Jingyi-11/Power-Grid-Frequency-Monitoring-System/docs/project Gannt Chart.pdf

Untitled Gantt Project | 16 Oct 2024
Gantt Chart | 4
Name | Begin date | End date | Priority | functional
Research & Requirements Analysis | 26/09/2024 | 11/10/2024 NORMAL
choose project direction | 26/09/2024 | 03/10/2024 NORMAL
Make Project plan | 07/10/2024 | 08/10/2024 NORMAL
write functional specification | 04/10/2024 | 11/10/2024 NORMAL
Hardware Development | 14/10/2024 | 29/11/2024 NORMAL
voltage measuring circuit design and testing | 14/10/2024 | 01/11/2024 NORMAL
purchase availble devices | 04/11/2024 | 04/11/2024 NORMAL
Project Review meeting 1 | 01/11/2024 | 01/11/2024 NORMAL
physical circuit implement | 05/11/2024 | 19/11/2024 NORMAL
microcontroller connection and data visualise | 18/11/2024 | 29/11/2024 NORMAL
Project Review meeting 2 | 29/11/2024 | 29/11/2024 NORMAL
write draft introduction and project methodology | 29/11/2024 | 06/12/2024 NORMAL
Submit Draft Introduction | 09/12/2024 | 09/12/2024 NORMAL
Academic Malpractice Awareness training (BB) | 13/12/2024 | 13/12/2024 NORMAL
Software Development | 27/01/2025 | 03/03/2025 NORMAL
coding for instant frequency visualization | 27/01/2025 | 03/02/2025 NORMAL
coding for data collection and store | 03/02/2025 | 21/02/2025 NORMAL
wireless communication implement | 24/02/2025 | 03/03/2025 NORMAL
write draft of final report | 24/02/2025 | 07/03/2025 NORMAL
Submit Draft of Final Report | 07/03/2025 | 07/03/2025 NORMAL
Optimization & Finalization | 10/03/2025 | 04/04/2025 NORMAL
check hardware and software | 10/03/2025 | 17/03/2025 NORMAL
modify the final report | 17/03/2025 | 04/04/2025 NORMAL
Submit Final Report | 04/04/2025 | 04/04/2025 NORMAL
Final Demonstration | 28/04/2025 | 28/04/2025 NORMAL
2024 | 2025
September | October | November | December | January | February | March | April | May
Hardware Development Project Review meeting 1 purchase availble devices Project Review meeting 2 Submit Draft Introduction Academic Malpractice Awareness train... | Submit Draft of Final Report Submit Final Report | Final Demonstration
