Jingyi-11/Power-Grid-Frequency-Monitoring-System/docs/schematic.PNG

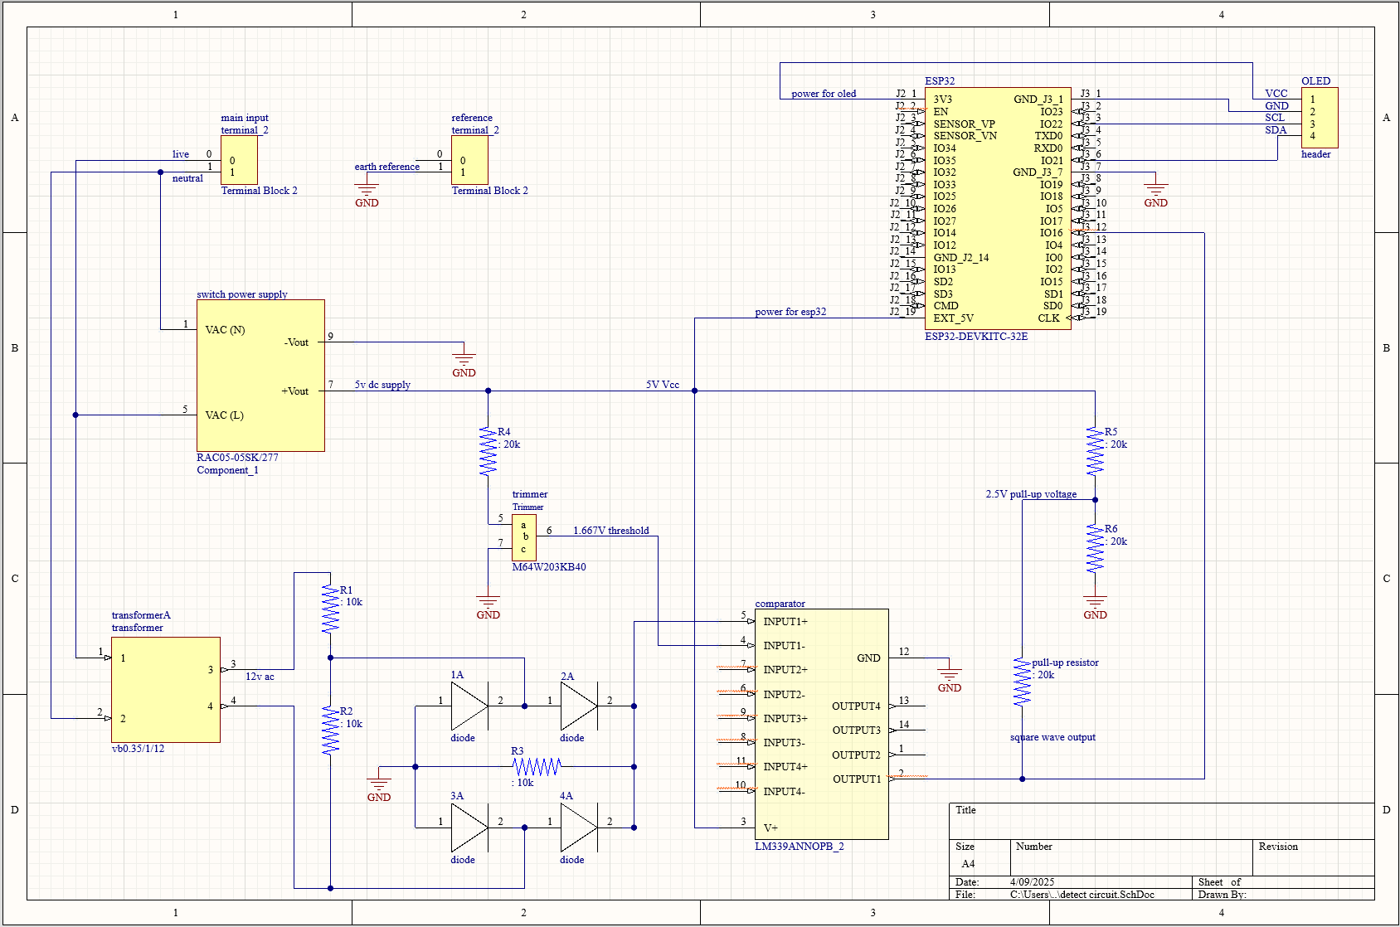
docs/schematic.PNG
